samsmith94/water-quality-monitoring-system/README.md

# Dokumentáció

## Kapcsolási rajz
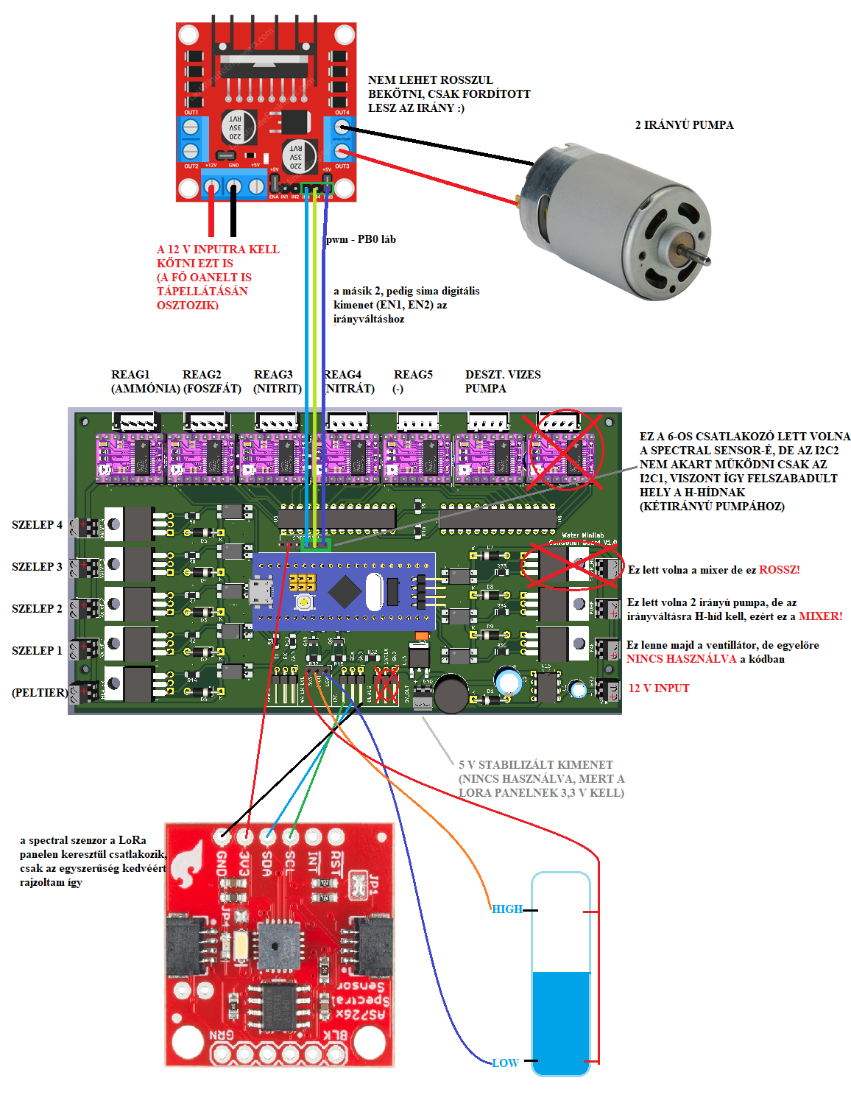
[picture p1: img/PCB.png]
Kapcsolas


## Websocket teszteléshez
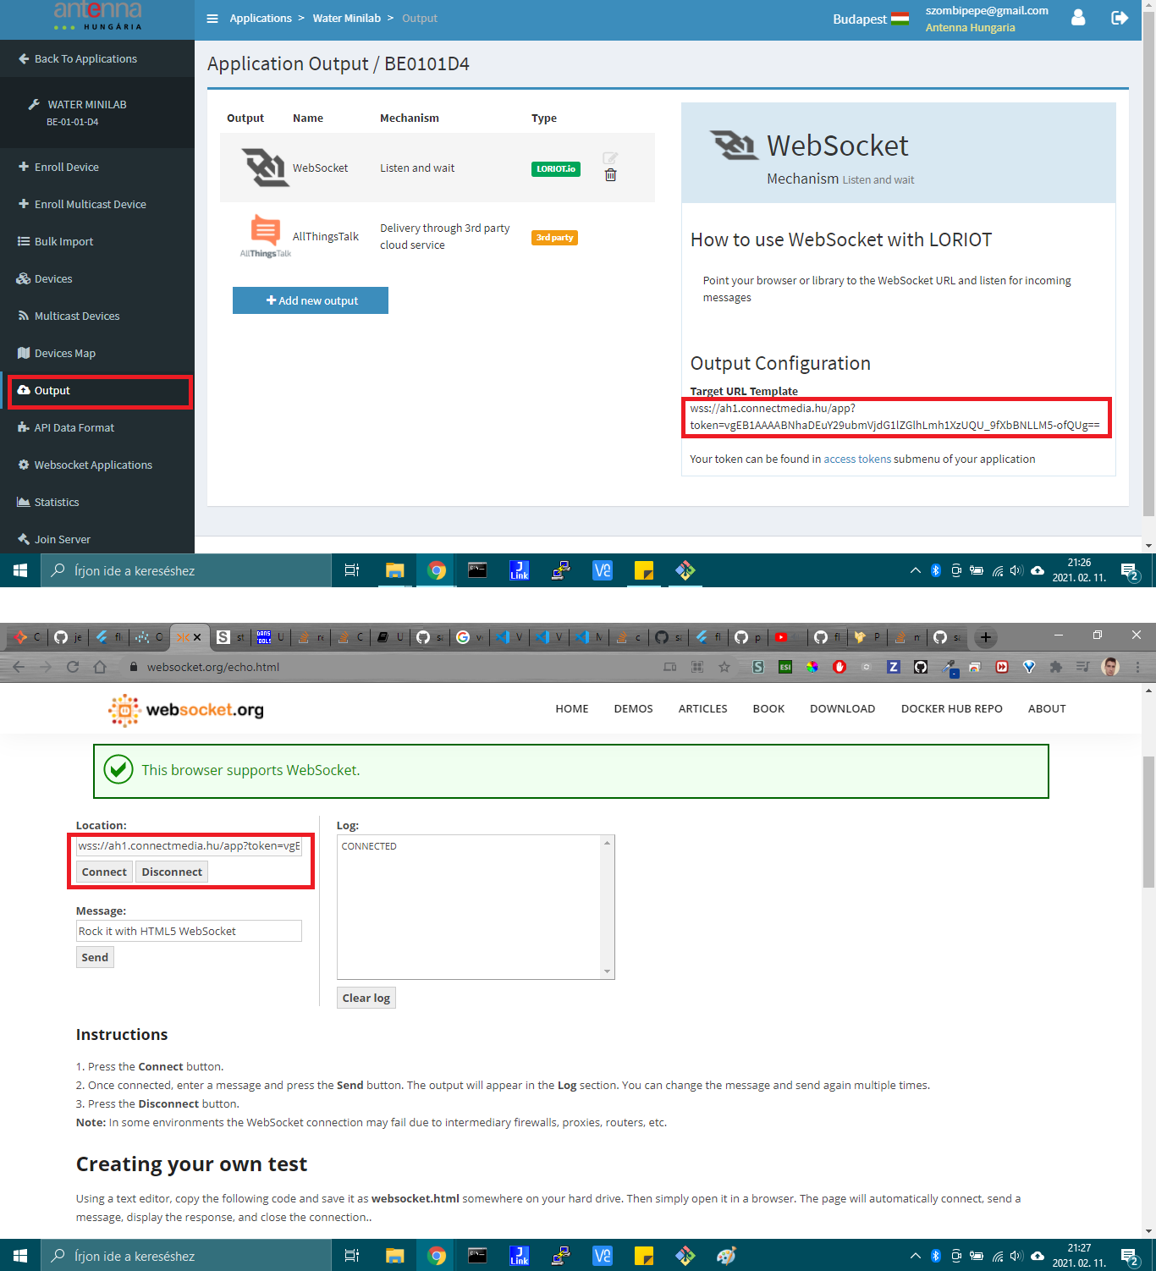
[picture p2: img/Websocket.png]
Websocket
