samsmith94/water-quality-monitoring-system/datasheets/Blue Pill Pinout.png

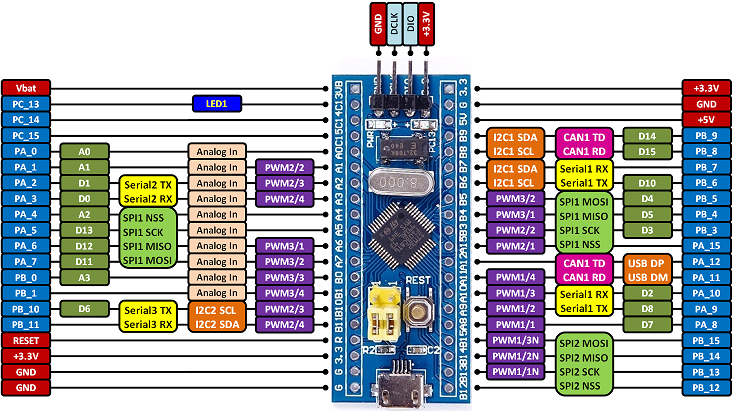
datasheets/Blue Pill Pinout.png
