samsmith94/water-quality-monitoring-system/hardware/PCB.kicad_pcb

## KiCad design hardware/PCB.kicad_pcb (2021-02-22)

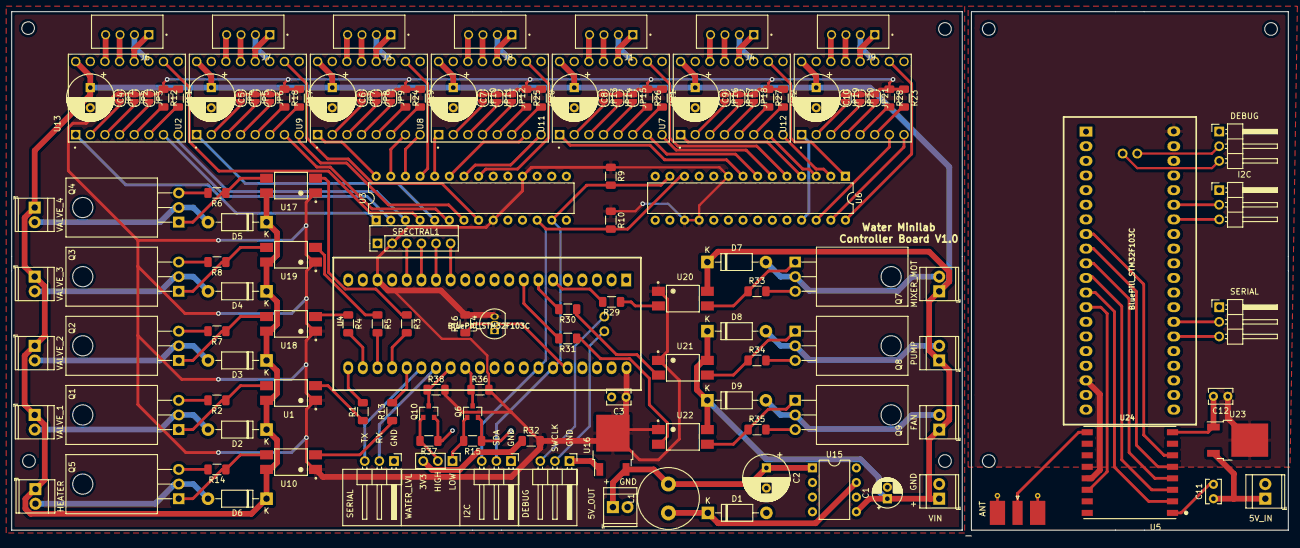
[picture p4: board PCB.kicad_pcb from above]

Board: 2 copper layers, 221.6 x 91.0 mm, 149 parts (0 on the bottom side), 156 nets.

Parts:
5V_IN: 5_V_IN; TerminalBlock_TE_282834-2_1x02_P2.54mm_Horizontal
5V_OUT: 5_V_OUT; TerminalBlock_TE_282834-2_1x02_P2.54mm_Horizontal
ANT: Conn_Coaxial; SMA_Molex_73251-2120_EdgeMount_Horizontal
C1: 22uF; CP_Radial_D5.0mm_P2.00mm
C2: 220uF; CP_Radial_D8.0mm_P3.50mm
C3, C11, C12: 10uF; C_Rect_L4.0mm_W2.5mm_P2.50mm
C4, C5, C6, C7, C8, C9, C10: 100uF; CP_Radial_D8.0mm_P3.50mm
D1: 1N5818; D_DO-41_SOD81_P10.16mm_Horizontal
D2, D3, D4, D5, D6, D7, D8, D9: 1N4001; D_DO-41_SOD81_P10.16mm_Horizontal
DEBUG: DEBUG2; PinHeader_1x03_P2.54mm_Horizontal
DEBUG#2: DEBUG1; PinHeader_1x03_P2.54mm_Horizontal
FAN: Screw_Terminal_01x02; TerminalBlock_TE_282834-2_1x02_P2.54mm_Horizontal
H1, H2, H3, H4, H5, H6, H7: MountingHole; MountingHole_2.2mm_M2
HEATER: Screw_Terminal_01x02; TerminalBlock_TE_282834-2_1x02_P2.54mm_Horizontal
I2C, I2C#2: BLUEPILL_2; PinHeader_1x03_P2.54mm_Horizontal
J1, J3, J4, J6, J7, J8, J9: B4B-XH-A(LF)(SN); JST_B4B-XH-A(LF)(SN)
JP1, JP2, JP3, JP4, JP5, JP6, JP7, JP8, JP9, JP10, JP11, JP12, JP13, JP14, JP15, JP16, JP17, JP18, JP19, JP20, JP21: Jumper; SolderJumper-2_P1.3mm_Open_RoundedPad1.0x1.5mm
L1: INDUCTOR; L_Radial_D10.5mm_P5.00mm_Abacron_AISR-01
MIXER_MOT: Screw_Terminal_01x02; TerminalBlock_TE_282834-2_1x02_P2.54mm_Horizontal
PUMP: Screw_Terminal_01x02; TerminalBlock_TE_282834-2_1x02_P2.54mm_Horizontal
Q1, Q2, Q3, Q4, Q5, Q7, Q8, Q9: IRL540NSTRLPBF; TO-220-3_Horizontal_TabDown
Q6, Q10: BC847; SOT-23
R1, R3, R4, R5, R13, R29, R30, R31: 330R; R_1206_3216Metric_Pad1.30x1.75mm_HandSolder
R2, R6, R7, R8, R11, R12, R14, R17, R18, R19, R20, R21, R22, R23, R24, R25, R26, R27, R28, R33, R34, R35: 10k; R_1206_3216Metric_Pad1.30x1.75mm_HandSolder
R9, R10: 1k; R_1206_3216Metric_Pad1.30x1.75mm_HandSolder
R15, R37: 220k; R_1206_3216Metric_Pad1.30x1.75mm_HandSolder
R16: 4k7; R_1206_3216Metric_Pad1.30x1.75mm_HandSolder
R32: 22k; R_1206_3216Metric_Pad1.30x1.75mm_HandSolder
R36, R38: 470R; R_1206_3216Metric_Pad1.30x1.75mm_HandSolder
SERIAL: SERIAL2; PinHeader_1x03_P2.54mm_Horizontal
SERIAL#2: SERIAL1; PinHeader_1x03_P2.54mm_Horizontal
SPECTRAL1: Conn_01x06_Male; PinHeader_1x06_P2.54mm_Vertical
U1, U10, U17, U18, U19, U20, U21, U22: PC817X2NIP1B; SOT254P975X400-4N
U2, U7, U8, U9, U11, U12, U13: DRV8825_STEPPER_MOTOR_DRIVER_CARRIER; DRV8825-M
U3, U6: MCP23017_SP; DIP-28_W7.62mm
U4, U24: BluePill_STM32F103C
U5: RFM95W-868S2; XCVR_RFM95W-868S2
U14: DS18B20; TO-92_Inline
U15: LM2574HVN-5; DIP-8_W7.62mm
U16, U23: LM1117-3.3; TO-252-2
VALVE_1, VALVE_2, VALVE_3, VALVE_4: Screw_Terminal_01x02; TerminalBlock_TE_282834-2_1x02_P2.54mm_Horizontal
VIN: Screw_Terminal_01x02; TerminalBlock_TE_282834-2_1x02_P2.54mm_Horizontal
WATER_LVL: Conn_01x03; PinHeader_1x03_P2.54mm_Vertical

Connections:
5_V_IN: 5V_IN.1, C11.1, U23.3
5_V_OUT: 5V_OUT.1, C2.1, L1.2, U15.1, U16.3
+3V3: C3.1, C12.1, JP1.1, JP2.1, JP3.1, JP4.1, JP5.1, JP6.1, JP7.1, JP8.1, JP9.1, JP10.1, JP11.1, JP12.1, JP13.1, JP14.1, JP15.1, JP16.1, JP17.1, JP18.1, JP19.1, JP20.1, JP21.1, R9.1, R10.1, R11.1, R12.1, R16.2, R17.1, R18.1, R19.1, R20.1, R21.1, R22.1, R23.1, R24.1, R25.1, R26.1, R27.1, R28.1, R32.2, R36.2, R38.2, SPECTRAL1.2, U1.1, U3.9, U3.18, U4.18, U4.40, U5.13, U6.9, U6.17, U6.18, U10.1, U14.3, U16.2, U17.1, U18.1, U19.1, U20.1, U21.1, U22.1, U23.2, U24.18, U24.40
+12V: C1.1, C4.1, C5.1, C6.1, C7.1, C8.1, C9.1, C10.1, D2.1, D3.1, D4.1, D5.1, D6.1, D7.1, D8.1, D9.1, FAN.1, HEATER.1, MIXER_MOT.1, PUMP.1, U1.4, U2.16, U7.16, U8.16, U9.16, U10.4, U11.16, U12.16, U13.16, U15.5, U17.4, U18.4, U19.4, U20.4, U21.4, U22.4, VALVE_1.1, VALVE_2.1, VALVE_3.1, VALVE_4.1, VIN.1
DEBUG_UART_RX_1: SERIAL#2.2, U4.27
DEBUG_UART_RX_2: SERIAL.2, U24.27
DEBUG_UART_TX_1: SERIAL#2.3, U4.26
DEBUG_UART_TX_2: SERIAL.3, U24.26
FAN_PWM: R31.2, U4.8
GND: 5V_IN.2, 5V_OUT.2, ANT.2, C1.2, C2.2, C3.2, C4.2, C5.2, C6.2, C7.2, C8.2, C9.2, C10.2, C11.2, C12.2, D1.2, DEBUG.1, DEBUG#2.1, I2C.1, I2C#2.1, Q1.3, Q2.3, Q3.3, Q4.3, Q5.3, Q6.2, Q7.3, Q8.3, Q9.3, Q10.2, R2.2, R6.2, R7.2, R8.2, R14.2, R15.1, R33.2, R34.2, R35.2, R37.1, SERIAL.1, SERIAL#2.1, SPECTRAL1.1, U2.9, U2.15, U3.10, U3.15, U3.16, U3.17, U4.19, U4.20, U4.39, U5.1, U5.8, U5.10, U6.10, U6.15, U6.16, U7.9, U7.15, U8.9, U8.15, U9.9, U9.15, U11.9, U11.15, U12.9, U12.15, U13.9, U13.15, U14.1, U15.2, U15.3, U15.4, U16.1, U23.1, U24.19, U24.20, U24.39, VIN.2
I2C2_SCL: I2C.3, I2C#2.3, R10.2, U3.12, U4.34, U6.12, U24.34
I2C2_SDA: I2C.2, I2C#2.2, R9.2, U3.13, U4.35, U6.13, U24.35
LORA_DIO0_INT: U5.14, U24.13
LORA_MISO: U5.3, U24.11
LORA_MOSI: U5.2, U24.12
LORA_NSS: U5.5, U24.9
LORA_RESET: U5.6, U24.8
LORA_SCK: U5.4, U24.10
MIXER_MOTOR_PWM: R29.2, U4.6
unnamed: D1.1, L1.1, U15.7
unnamed: D2.2, Q1.2, VALVE_1.2
unnamed: D3.2, Q2.2, VALVE_2.2
unnamed: D4.2, Q3.2, VALVE_3.2
unnamed: D5.2, Q4.2, VALVE_4.2
unnamed: D6.2, HEATER.2, Q5.2
unnamed: D7.2, MIXER_MOT.2, Q7.2
unnamed: D8.2, PUMP.2, Q8.2
unnamed: D9.2, FAN.2, Q9.2
unnamed: ANT.1, U5.9
unnamed: JP1.2, U13.2
unnamed: JP2.2, U13.3
unnamed: JP3.2, U13.4
unnamed: JP4.2, U2.2
unnamed: JP5.2, U2.3
unnamed: JP6.2, U2.4
unnamed: JP7.2, U9.2
unnamed: JP8.2, U9.3
unnamed: JP9.2, U9.4
unnamed: JP10.2, U8.2
unnamed: JP11.2, U8.3
unnamed: JP12.2, U8.4
unnamed: JP13.2, U11.2
unnamed: JP14.2, U11.3
unnamed: JP15.2, U11.4
unnamed: JP16.2, U7.2
unnamed: JP17.2, U7.3
unnamed: JP18.2, U7.4
unnamed: JP19.2, U12.2
unnamed: JP20.2, U12.3
unnamed: JP21.2, U12.4
unnamed: Q1.1, R2.1, U1.3
unnamed: Q2.1, R7.1, U18.3
unnamed: Q3.1, R8.1, U19.3
unnamed: Q4.1, R6.1, U17.3
unnamed: Q5.1, R14.1, U10.3
unnamed: Q6.1, R15.2, WATER_LVL.1
unnamed: Q7.1, R33.1, U20.3
unnamed: Q8.1, R34.1, U21.3
unnamed: Q9.1, R35.1, U22.3
unnamed: Q10.1, R37.2, WATER_LVL.2
unnamed: R1.1, U1.2
unnamed: R3.1, U17.2
unnamed: R4.1, U18.2
unnamed: R5.1, U19.2
unnamed: R11.2, U13.6
unnamed: R12.2, U13.5
unnamed: R13.1, U10.2
unnamed: R17.2, U2.6
unnamed: R18.2, U2.5
unnamed: R19.2, U9.6
unnamed: R20.2, U8.6
unnamed: R21.2, U11.6
unnamed: R22.2, U7.6
unnamed: R23.2, U12.6
unnamed: R24.2, U9.5
unnamed: R25.2, U8.5
unnamed: R26.2, U11.5
unnamed: R27.2, U7.5
unnamed: R28.2, U12.5
unnamed: R29.1, U20.2
unnamed: R30.1, U21.2
unnamed: R31.1, U22.2
unnamed: R32.1, WATER_LVL.3
PELTIER: R13.2, U4.25
PUMP_PWM: R30.2, U4.7
SPECTRAL_I2C_INT: SPECTRAL1.5, U4.14
SPECTRAL_I2C_RST: SPECTRAL1.6, U4.13
SPECTRAL_I2C_SCL: SPECTRAL1.4, U4.15
SPECTRAL_I2C_SDA: SPECTRAL1.3, U4.16
STEPPER_MOT1_A1: J6.1, U13.12
STEPPER_MOT1_A2: J6.2, U13.11
STEPPER_MOT1_B1: J6.3, U13.13
STEPPER_MOT1_B2: J6.4, U13.14
STEPPER_MOT1_DIR: U3.3, U13.8
STEPPER_MOT1_EN: U3.1, U13.1
STEPPER_MOT1_FLT: U3.4, U13.10
STEPPER_MOT1_STEP: U3.2, U13.7
STEPPER_MOT2_A1: J7.1, U2.12
STEPPER_MOT2_A2: J7.2, U2.11
STEPPER_MOT2_B1: J7.3, U2.13
STEPPER_MOT2_B2: J7.4, U2.14
STEPPER_MOT2_DIR: U2.8, U3.7
STEPPER_MOT2_EN: U2.1, U3.5
STEPPER_MOT2_FLT: U2.10, U3.8
STEPPER_MOT2_STEP: U2.7, U3.6
STEPPER_MOT3_A1: J3.1, U9.12
STEPPER_MOT3_A2: J3.2, U9.11
STEPPER_MOT3_B1: J3.3, U9.13
STEPPER_MOT3_B2: J3.4, U9.14
STEPPER_MOT3_DIR: U3.26, U9.8
STEPPER_MOT3_EN: U3.28, U9.1
STEPPER_MOT3_FLT: U3.25, U9.10
STEPPER_MOT3_STEP: U3.27, U9.7
STEPPER_MOT4_A1: J8.1, U8.12
STEPPER_MOT4_A2: J8.2, U8.11
STEPPER_MOT4_B1: J8.3, U8.13
STEPPER_MOT4_B2: J8.4, U8.14
STEPPER_MOT4_DIR: U3.22, U8.8
STEPPER_MOT4_EN: U3.24, U8.1
STEPPER_MOT4_FLT: U3.21, U8.10
STEPPER_MOT4_STEP: U3.23, U8.7
STEPPER_MOT5_A1: J1.1, U11.12
STEPPER_MOT5_A2: J1.2, U11.11
STEPPER_MOT5_B1: J1.3, U11.13
STEPPER_MOT5_B2: J1.4, U11.14
STEPPER_MOT5_DIR: U6.6, U11.8
STEPPER_MOT5_EN: U6.8, U11.1
STEPPER_MOT5_FLT: U6.5, U11.10
STEPPER_MOT5_STEP: U6.7, U11.7
STEPPER_MOT6_A1: J4.1, U7.12
STEPPER_MOT6_A2: J4.2, U7.11
STEPPER_MOT6_B1: J4.3, U7.13
STEPPER_MOT6_B2: J4.4, U7.14
STEPPER_MOT6_DIR: U6.2, U7.8
STEPPER_MOT6_EN: U6.4, U7.1
STEPPER_MOT6_FLT: U6.1, U7.10
STEPPER_MOT6_STEP: U6.3, U7.7
STEPPER_MOT7_A1: J9.1, U12.12
STEPPER_MOT7_A2: J9.2, U12.11
STEPPER_MOT7_B1: J9.3, U12.13
STEPPER_MOT7_B2: J9.4, U12.14
STEPPER_MOT7_DIR: U6.27, U12.8
STEPPER_MOT7_EN: U6.25, U12.1
STEPPER_MOT7_FLT: U6.28, U12.10
STEPPER_MOT7_STEP: U6.26, U12.7
SWCLK_1: DEBUG#2.2, U4.41
SWCLK_2: DEBUG.2, U24.41
SWDIO_1: DEBUG#2.3, U4.42
SWDIO_2: DEBUG.3, U24.42
TEMPERATURE: R16.1, U4.36, U14.2
VALVE_1: R1.2, U4.21
VALVE_2: R4.2, U4.22
VALVE_3: R5.2, U4.23
VALVE_4: R3.2, U4.24
WATER_HIGH_LEVEL: Q10.3, R38.1, U4.28
WATER_LOW_LEVEL: Q6.3, R36.1, U4.29
