samsmith94/water-quality-monitoring-system/lora-wan/src/main.cpp

/*******************************************************************************
 * Copyright (c) 2015 Thomas Telkamp and Matthijs Kooijman
 * Copyright (c) 2018 Terry Moore, MCCI
 *
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
 * This example sends a valid LoRaWAN packet with payload "Hello,
 * world!", using frequency and encryption settings matching those of
 * the The Things Network.
 *
 * This uses ABP (Activation-by-personalisation), where a DevAddr and
 * Session keys are preconfigured (unlike OTAA, where a DevEUI and
 * application key is configured, while the DevAddr and session keys are
 * assigned/generated in the over-the-air-activation procedure).
 *
 * Note: LoRaWAN per sub-band duty-cycle limitation is enforced (1% in
 * g1, 0.1% in g2), but not the TTN fair usage policy (which is probably
 * violated by this sketch when left running for longer)!
 *
 * To use this sketch, first register your application and device with
 * the things network, to set or generate a DevAddr, NwkSKey and
 * AppSKey. Each device should have their own unique values for these
 * fields.
 *
 * Do not forget to define the radio type correctly in
 * arduino-lmic/project_config/lmic_project_config.h or from your BOARDS.txt.
 *
 *******************************************************************************/

#include <Arduino.h>

#include <lmic.h>
#include <hal/hal.h>
#include <SPI.h>

#include <Wire.h>
#include "AS726X.h"

static char loradata[70] = {'\0'};
static uint8_t idx = 0;

static bool dataReady = false;

bool dataSentOnLora = false;
//
// For normal use, we require that you edit the sketch to replace FILLMEIN
// with values assigned by the TTN console. However, for regression tests,
// we want to be able to compile these scripts. The regression tests define
// COMPILE_REGRESSION_TEST, and in that case we define FILLMEIN to a non-
// working but innocuous value.
//
#ifdef COMPILE_REGRESSION_TEST
#define FILLMEIN 0
#else
#warning "You must replace the values marked FILLMEIN with real values from the TTN control panel!"
#define FILLMEIN (#dont edit this, edit the lines that use FILLMEIN)
#endif

// LoRaWAN NwkSKey, network session key
static const PROGMEM u1_t NWKSKEY[16] = {0xA0, 0x58, 0xF8, 0xA7, 0x32, 0x18, 0xB0, 0x94, 0x09, 0x9D, 0x04, 0xA5, 0xB6, 0x43, 0x4A, 0x7C};
//static const PROGMEM u1_t NWKSKEY[16] = { 0xC7, 0x42, 0x86, 0x6F, 0xE1, 0x50, 0xF5, 0xC9, 0x2C, 0xB8, 0x97, 0xF0, 0x57, 0xBE, 0xFB, 0xC6 };

// LoRaWAN AppSKey, application session key
static const u1_t PROGMEM APPSKEY[16] = {0x48, 0xD3, 0xC2, 0xD1, 0xBB, 0xA3, 0xD5, 0x9E, 0x20, 0xB5, 0xE8, 0xF9, 0x10, 0xAC, 0x29, 0xCF};
//static const u1_t PROGMEM APPSKEY[16] = { 0x16, 0xED, 0x64, 0x45, 0x2A, 0x47, 0x48, 0x3F, 0x0D, 0xD1, 0xDD, 0x48, 0x15, 0x39, 0xB7, 0x9E };

// LoRaWAN end-device address (DevAddr)
// See http://thethingsnetwork.org/wiki/AddressSpace
// The library converts the address to network byte order as needed.
static const u4_t DEVADDR = 0x066F0BF7; // <-- Change this address for every node!
//static const u4_t DEVADDR = 0x26011F03;

// These callbacks are only used in over-the-air activation, so they are
// left empty here (we cannot leave them out completely unless
// DISABLE_JOIN is set in arduino-lmic/project_config/lmic_project_config.h,
// otherwise the linker will complain).
void os_getArtEui(u1_t *buf) {}
void os_getDevEui(u1_t *buf) {}
void os_getDevKey(u1_t *buf) {}

static uint8_t mydata[] = "Hello, world!";
static osjob_t sendjob;

// Schedule TX every this many seconds (might become longer due to duty
// cycle limitations).
const unsigned TX_INTERVAL = 60;

// Pin mapping
// Adapted for Feather M0 per p.10 of [feather]
const lmic_pinmap lmic_pins = {
    .nss = PA4,
    .rxtx = 0xFF,
    .rst = 0xFF,
    //.rst = PA2,
    .dio = {PA0, PA1, 0xFF},
};

void do_send(osjob_t *j)
{
  // Check if there is not a current TX/RX job running
  if (LMIC.opmode & OP_TXRXPEND)
  {
    Serial.println(F("OP_TXRXPEND, not sending"));
  }
  else
  {
    
    LMIC_setTxData2(1, (uint8_t *)loradata, sizeof(loradata) - 1, 0);
    Serial.print("Packet queued: ");
    Serial.println(loradata);
    /*
    if (dataReady)
    {
      // Prepare upstream data transmission at the next possible time.
      LMIC_setTxData2(1, (uint8_t *)loradata, sizeof(loradata) - 1, 0);
      Serial.print("Packet queued: ");
      Serial.println(loradata);
    }
    else
    {
      //memset(loradata, '\0', sizeof(loradata));

      char empty[] = "No data.";
      
      LMIC_setTxData2(1, (uint8_t *)empty, sizeof(empty) - 1, 0);
      Serial.println("Packet queued: ");
      Serial.println(empty);
    }
    */

    /*
    while(!dataReady);
      memcpy(data, loradata, 70);
      LMIC_setTxData2(1, data, sizeof(data) - 1, 0);
      memset(loradata, '\0', sizeof(loradata));
      dataReady = false;
      */
    /*
    if (dataReady) {
    LMIC_setTxData2(1, mydata, sizeof(mydata) - 1, 0);
    Serial.println(F("Packet queued"));
    }
    */
  }
  // Next TX is scheduled after TX_COMPLETE event.
}

void onEvent(ev_t ev)
{
  Serial.print(os_getTime());
  Serial.print(": ");
  switch (ev)
  {
  case EV_SCAN_TIMEOUT:
    Serial.println(F("EV_SCAN_TIMEOUT"));
    break;
  case EV_BEACON_FOUND:
    Serial.println(F("EV_BEACON_FOUND"));
    break;
  case EV_BEACON_MISSED:
    Serial.println(F("EV_BEACON_MISSED"));
    break;
  case EV_BEACON_TRACKED:
    Serial.println(F("EV_BEACON_TRACKED"));
    break;
  case EV_JOINING:
    Serial.println(F("EV_JOINING"));
    break;
  case EV_JOINED:
    Serial.println(F("EV_JOINED"));
    break;
  /*
        || This event is defined but not used in the code. No
        || point in wasting codespace on it.
        ||
        || case EV_RFU1:
        ||     Serial.println(F("EV_RFU1"));
        ||     break;
        */
  case EV_JOIN_FAILED:
    Serial.println(F("EV_JOIN_FAILED"));
    break;
  case EV_REJOIN_FAILED:
    Serial.println(F("EV_REJOIN_FAILED"));
    break;
  case EV_TXCOMPLETE:
    Serial.println(F("EV_TXCOMPLETE (includes waiting for RX windows)"));
    if (LMIC.txrxFlags & TXRX_ACK)
      Serial.println(F("Received ack"));
    if (LMIC.dataLen)
    {
      Serial.println(F("Received "));
      Serial.println(LMIC.dataLen);
      Serial.println(F(" bytes of payload"));
    }
    dataSentOnLora = true;

    // Schedule next transmission
    os_setTimedCallback(&sendjob, os_getTime() + sec2osticks(TX_INTERVAL), do_send);

    break;
  case EV_LOST_TSYNC:
    Serial.println(F("EV_LOST_TSYNC"));
    break;
  case EV_RESET:
    Serial.println(F("EV_RESET"));
    break;
  case EV_RXCOMPLETE:
    // data received in ping slot
    Serial.println(F("EV_RXCOMPLETE"));

    
    break;
  case EV_LINK_DEAD:
    Serial.println(F("EV_LINK_DEAD"));
    break;
  case EV_LINK_ALIVE:
    Serial.println(F("EV_LINK_ALIVE"));
    break;
  /*
        || This event is defined but not used in the code. No
        || point in wasting codespace on it.
        ||
        || case EV_SCAN_FOUND:
        ||    Serial.println(F("EV_SCAN_FOUND"));
        ||    break;
        */
  case EV_TXSTART:
    Serial.println(F("EV_TXSTART"));
    break;
  default:
    Serial.print(F("Unknown event: "));
    Serial.println((unsigned)ev);
    break;
  }
}

/******************************************************************************/
void receiveEvent(int howMany);
/******************************************************************************/
void setup()
{
  pinMode(PC13, OUTPUT);
  digitalWrite(PC13, HIGH);

  while (!Serial)
    ; // wait for Serial to be initialized
  Serial.begin(115200);
  delay(100); // per sample code on RF_95 test
  Serial.println(F("Starting"));

  Wire.begin(8);
  Wire.onReceive(receiveEvent);
  delay(1000);

#ifdef VCC_ENABLE
  // For Pinoccio Scout boards
  pinMode(VCC_ENABLE, OUTPUT);
  digitalWrite(VCC_ENABLE, HIGH);
  delay(1000);
#endif

  // LMIC init
  os_init();
  // Reset the MAC state. Session and pending data transfers will be discarded.
  LMIC_reset();

// Set static session parameters. Instead of dynamically establishing a session
// by joining the network, precomputed session parameters are be provided.
#ifdef PROGMEM
  // On AVR, these values are stored in flash and only copied to RAM
  // once. Copy them to a temporary buffer here, LMIC_setSession will
  // copy them into a buffer of its own again.
  uint8_t appskey[sizeof(APPSKEY)];
  uint8_t nwkskey[sizeof(NWKSKEY)];
  memcpy_P(appskey, APPSKEY, sizeof(APPSKEY));
  memcpy_P(nwkskey, NWKSKEY, sizeof(NWKSKEY));
  LMIC_setSession(0x13, DEVADDR, nwkskey, appskey);
#else
  // If not running an AVR with PROGMEM, just use the arrays directly
  LMIC_setSession(0x13, DEVADDR, NWKSKEY, APPSKEY);
#endif

#if defined(CFG_eu868)
  // Set up the channels used by the Things Network, which corresponds
  // to the defaults of most gateways. Without this, only three base
  // channels from the LoRaWAN specification are used, which certainly
  // works, so it is good for debugging, but can overload those
  // frequencies, so be sure to configure the full frequency range of
  // your network here (unless your network autoconfigures them).
  // Setting up channels should happen after LMIC_setSession, as that
  // configures the minimal channel set.
  LMIC_setupChannel(0, 868100000, DR_RANGE_MAP(DR_SF12, DR_SF7), BAND_CENTI);  // g-band
  LMIC_setupChannel(1, 868300000, DR_RANGE_MAP(DR_SF12, DR_SF7B), BAND_CENTI); // g-band
  LMIC_setupChannel(2, 868500000, DR_RANGE_MAP(DR_SF12, DR_SF7), BAND_CENTI);  // g-band
  LMIC_setupChannel(3, 867100000, DR_RANGE_MAP(DR_SF12, DR_SF7), BAND_CENTI);  // g-band
  LMIC_setupChannel(4, 867300000, DR_RANGE_MAP(DR_SF12, DR_SF7), BAND_CENTI);  // g-band
  LMIC_setupChannel(5, 867500000, DR_RANGE_MAP(DR_SF12, DR_SF7), BAND_CENTI);  // g-band
  LMIC_setupChannel(6, 867700000, DR_RANGE_MAP(DR_SF12, DR_SF7), BAND_CENTI);  // g-band
  LMIC_setupChannel(7, 867900000, DR_RANGE_MAP(DR_SF12, DR_SF7), BAND_CENTI);  // g-band
  LMIC_setupChannel(8, 868800000, DR_RANGE_MAP(DR_FSK, DR_FSK), BAND_MILLI);   // g2-band
// TTN defines an additional channel at 869.525Mhz using SF9 for class B
// devices' ping slots. LMIC does not have an easy way to define set this
// frequency and support for class B is spotty and untested, so this
// frequency is not configured here.
#elif defined(CFG_us915)
  // NA-US channels 0-71 are configured automatically
  // but only one group of 8 should (a subband) should be active
  // TTN recommends the second sub band, 1 in a zero based count.
  // https://github.com/TheThingsNetwork/gateway-conf/blob/master/US-global_conf.json
  LMIC_selectSubBand(1);
#endif

  // Disable link check validation
  LMIC_setLinkCheckMode(0);

  // TTN uses SF9 for its RX2 window.
  LMIC.dn2Dr = DR_SF9;
  //LMIC.dn2Dr = EU868_DR_SF7B;

  // Set data rate and transmit power for uplink (note: txpow seems to be ignored by the library)
  LMIC_setDrTxpow(DR_SF7, 14);

  LMIC_setClockError(MAX_CLOCK_ERROR * 10 / 100);

  // Start job
  do_send(&sendjob);
}

void loop()
{
  
  unsigned long now;
  now = millis();
  if ((now & 512) != 0)
  {
    digitalWrite(PC13, HIGH);
  }
  else
  {
    digitalWrite(PC13, LOW);
  }

  os_runloop_once();
}

void receiveEvent(int howMany)
{
  byte a = Wire.read();

  //Serial.println("REC");

  if (a != '\n')
  {
    loradata[idx] = a;
    idx++;
  }
  else
  {
    idx = 0;
    Serial.println("Received on I2C:");
    Serial.println(loradata);
    dataReady = true;

    //do_send(&sendjob);
  }
}
